phorton1/Arduino-fridgeController/docs/images/elec_board1_schematic_big.jpg

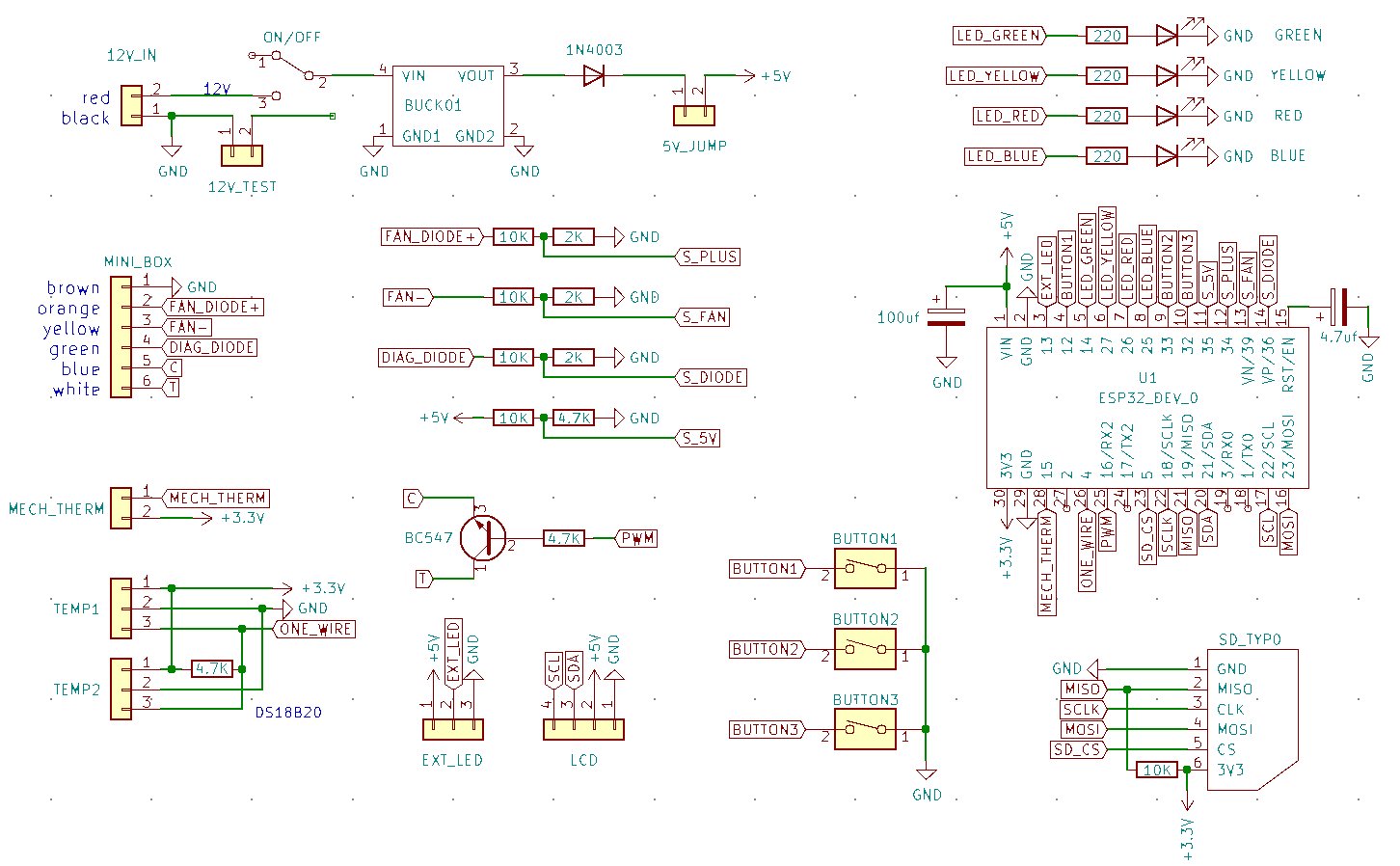
docs/images/elec_board1_schematic_big.jpg
