phorton1/Arduino-fridgeController/docs/images/miniBoxCover_lightburn.jpg

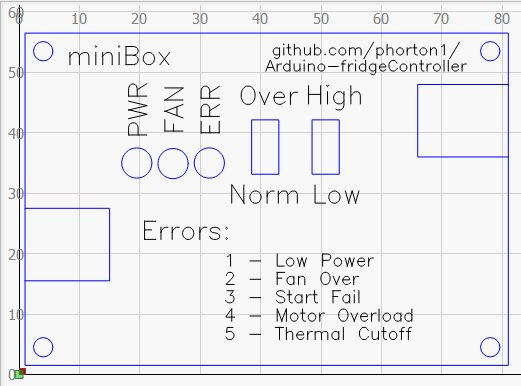
docs/images/miniBoxCover_lightburn.jpg
