phorton1/Arduino-fridgeController/docs/fusion/ext_lens.stl

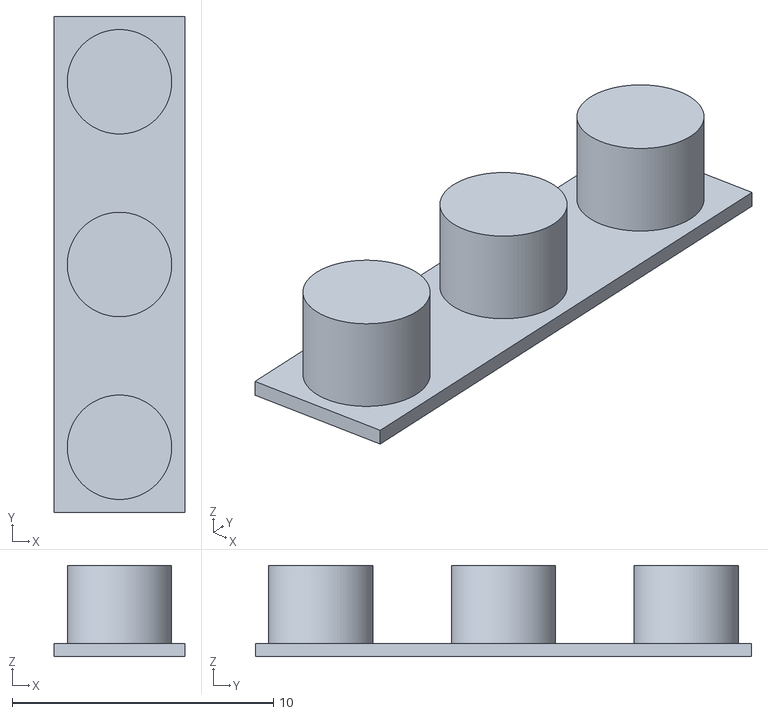
[picture p24: CAD file, 2024-10-18]
docs/fusion/ext_lens.stl
5.00 x 19.0 x 3.50
