phorton1/Arduino-fridgeController/docs/prusa/ext_led_parts.3mf

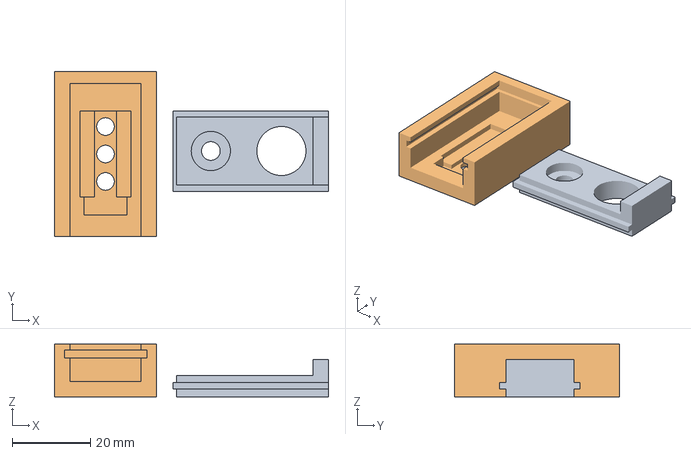
[picture p25: CAD file, 2024-10-18]
docs/prusa/ext_led_parts.3mf
69.9 x 42.0 x 13.5 mm
ext_base.stl
ext_top.stl
