phorton1/Arduino-fridgeController/docs/fusion/ext_top.stl

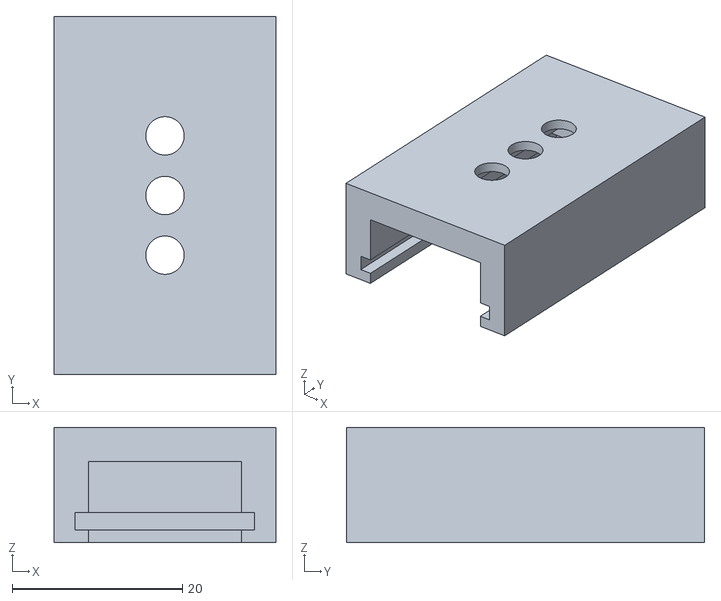
[picture p26: CAD file, 2024-10-18]
docs/fusion/ext_top.stl
26.0 x 42.0 x 13.5
