phorton1/Arduino-fridgeController/docs/prusa/stress_relief_bracket.3mf

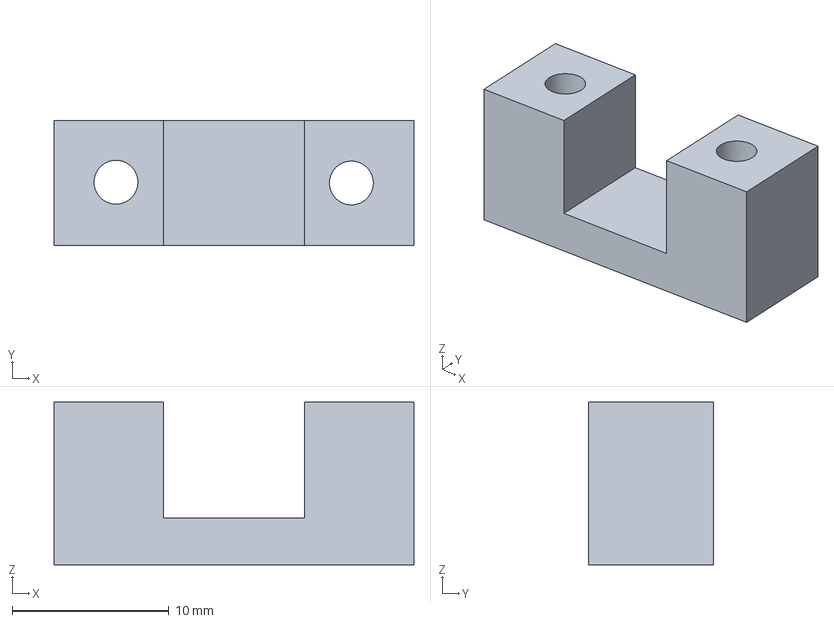
[picture p27: CAD file, 2024-10-18]
docs/prusa/stress_relief_bracket.3mf
23.0 x 8.00 x 10.4 mm
