phorton1/Arduino-fridgeController/docs/fusion/ext_base.stl

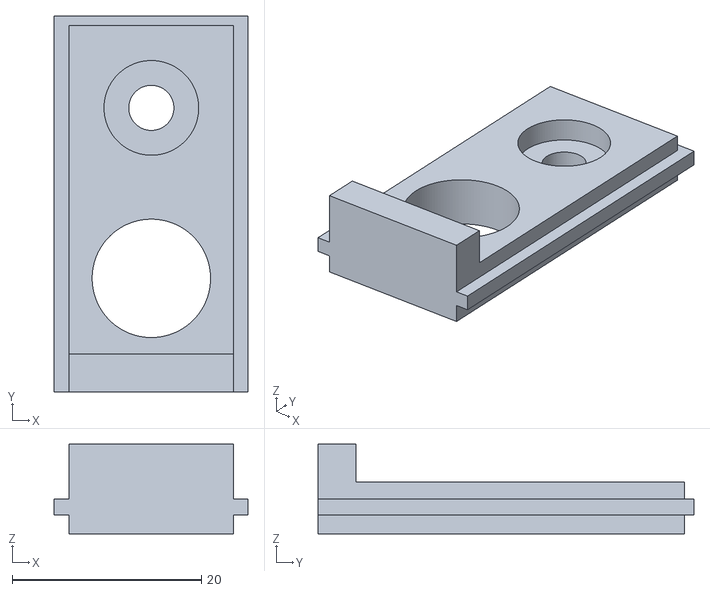
[picture p28: CAD file, 2024-10-18]
docs/fusion/ext_base.stl
20.5 x 39.7 x 9.50
