phorton1/Arduino-fridgeController/docs/prusa/cover_clips.3mf

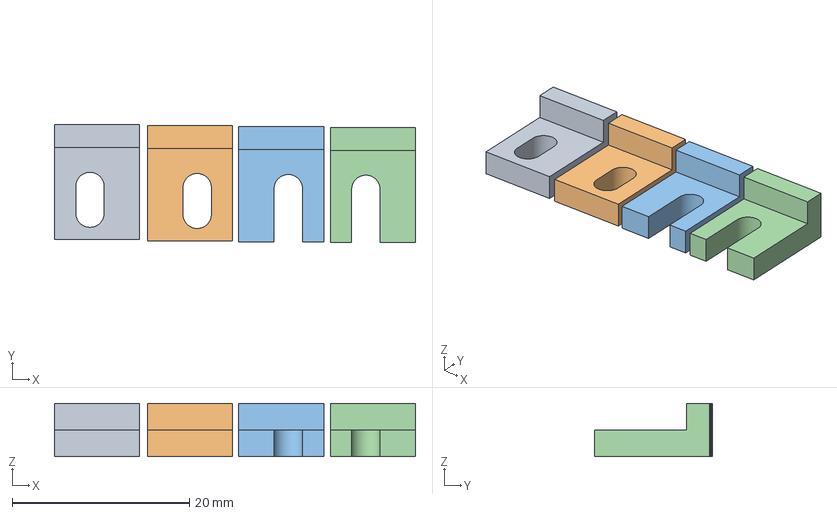
[picture p29: CAD file, 2024-10-11]
docs/prusa/cover_clips.3mf
40.7 x 13.3 x 6.00 mm
cover_clip_bl.stl
cover_clip_br.stl
cover_clip_tr.stl
cover_ clip_tl.stl
