phorton1/Arduino-fridgeController/docs/fusion/cover_clip_bl.stl

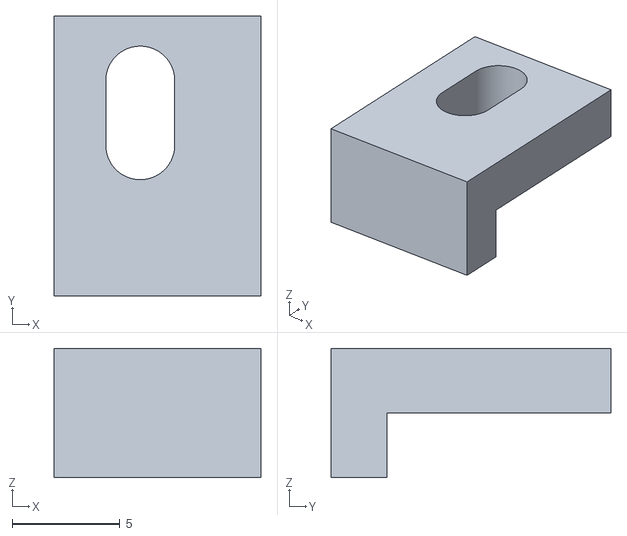
[picture p30: CAD file, 2024-10-11]
docs/fusion/cover_clip_bl.stl
9.60 x 13.0 x 6.00
