phorton1/Arduino-fridgeController/docs/prusa/Lenses.3mf

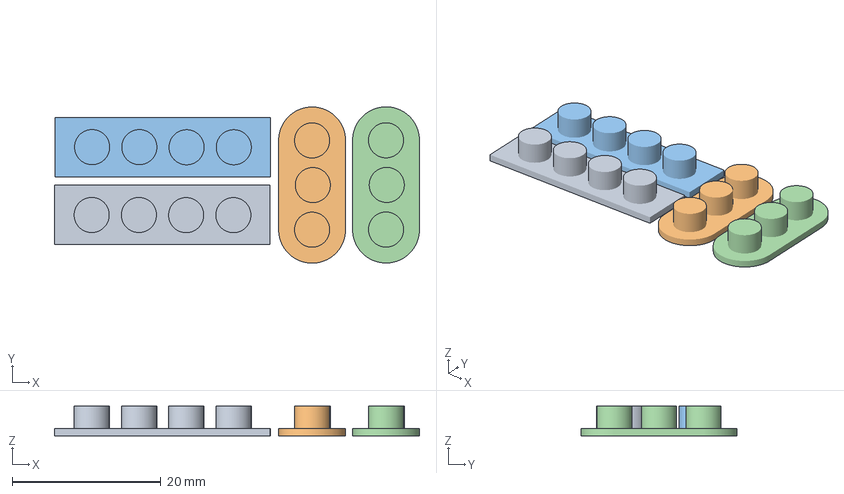
[picture p31: CAD file, 2024-10-10]
docs/prusa/Lenses.3mf
49.1 x 21.0 x 4.00 mm
Controller_led_lens.stl x 2
miniBox_lens.stl x 2
