phorton1/Arduino-fridgeController/docs/fusion/cover_ clip_tl.stl

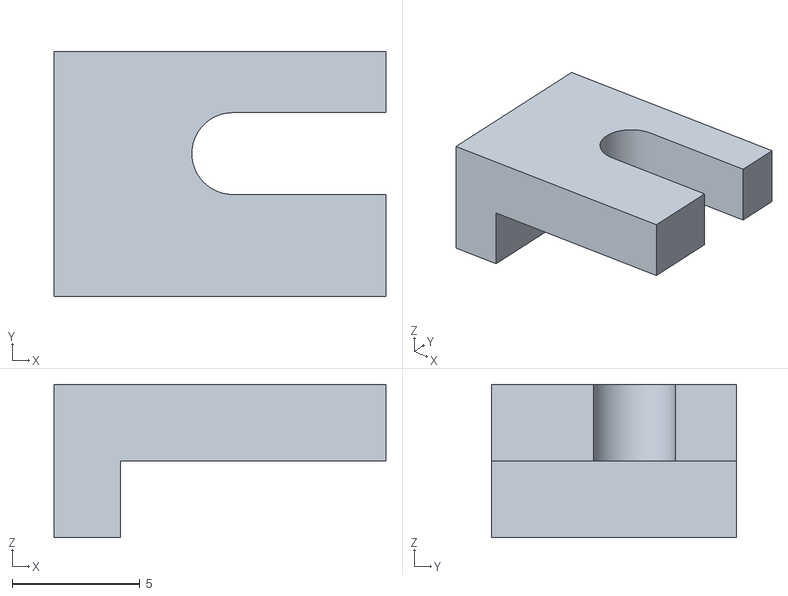
[picture p32: CAD file, 2024-10-11]
docs/fusion/cover_ clip_tl.stl
13.0 x 9.60 x 6.00
