phorton1/Arduino-fridgeController/docs/prusa/miniBox_lens_shield.3mf

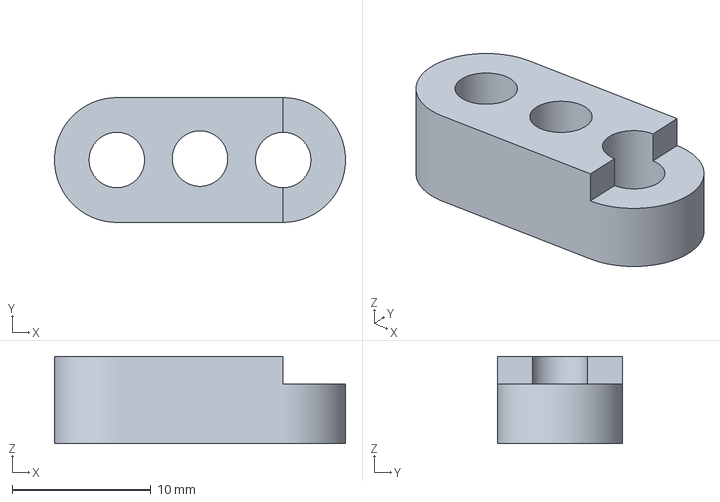
[picture p33: CAD file, 2024-10-08]
docs/prusa/miniBox_lens_shield.3mf
21.0 x 9.00 x 6.30 mm
