phorton1/Arduino-fridgeController/docs/prusa/ControllerParts.3mf

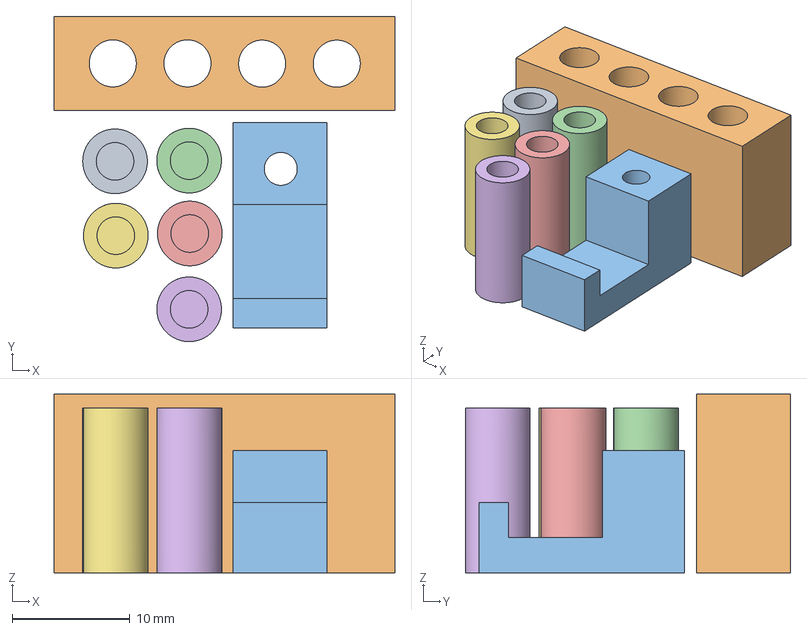
[picture p34: CAD file, 2024-10-08]
docs/prusa/ControllerParts.3mf
29.0 x 27.7 x 15.2 mm
button_cap1_smaller.stl x 2
Controller_led_shield.stl
stress_relief_bracket.stl
button_cap2.stl x 3
