phorton1/Arduino-fridgeController/docs/fusion/Controller_base.3mf

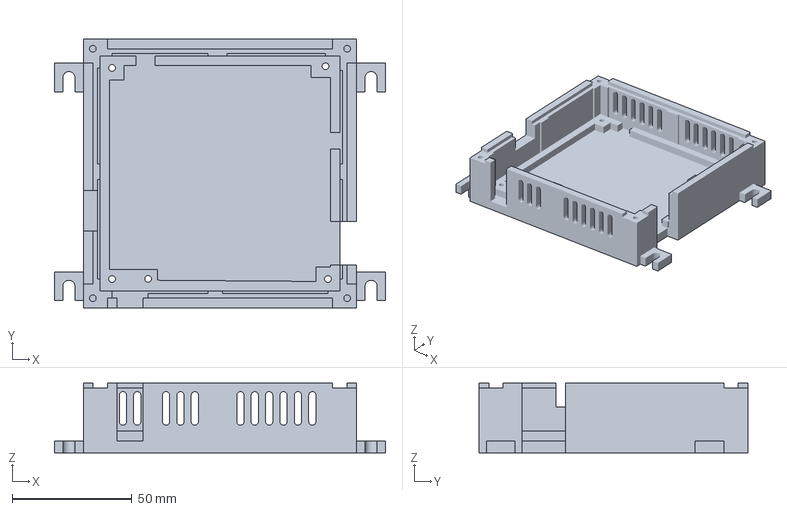
[picture p35: CAD file, 2024-10-11]
docs/fusion/Controller_base.3mf
138.0 x 112.0 x 29.0 mm
