phorton1/Arduino-fridgeController/docs/prusa/spade_connector_bottom.3mf

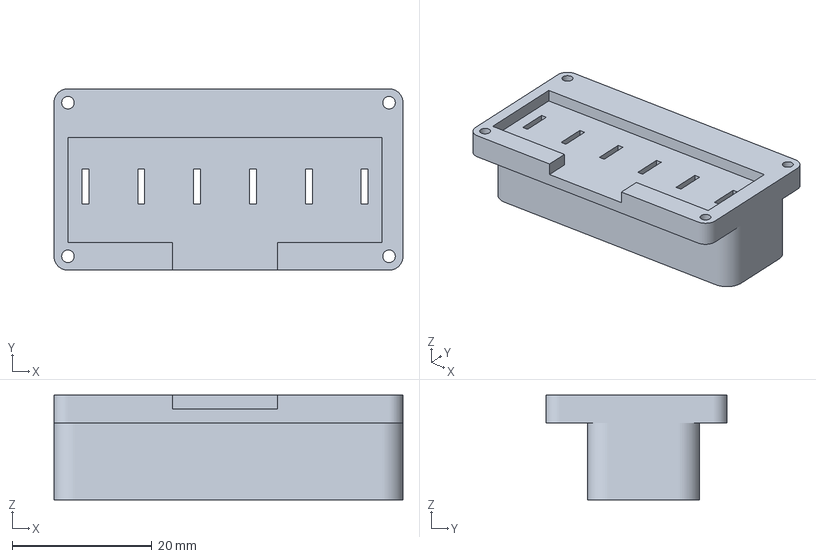
[picture p36: CAD file, 2024-10-06]
docs/prusa/spade_connector_bottom.3mf
50.0 x 26.0 x 15.0 mm
