phorton1/Arduino-fridgeController/docs/prusa/spade_connector_top.3mf

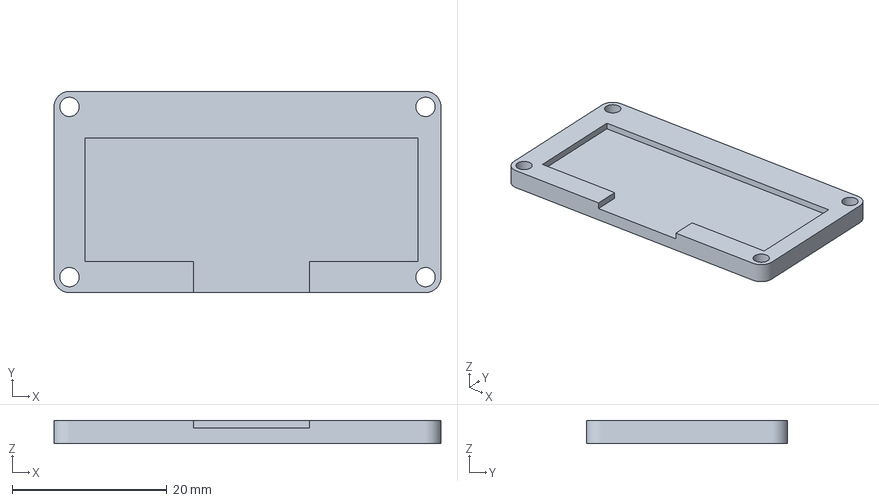
[picture p37: CAD file, 2024-10-06]
docs/prusa/spade_connector_top.3mf
50.0 x 26.0 x 3.00 mm
