phorton1/Arduino-fridgeController/docs/fusion/Controller_led_lens.stl

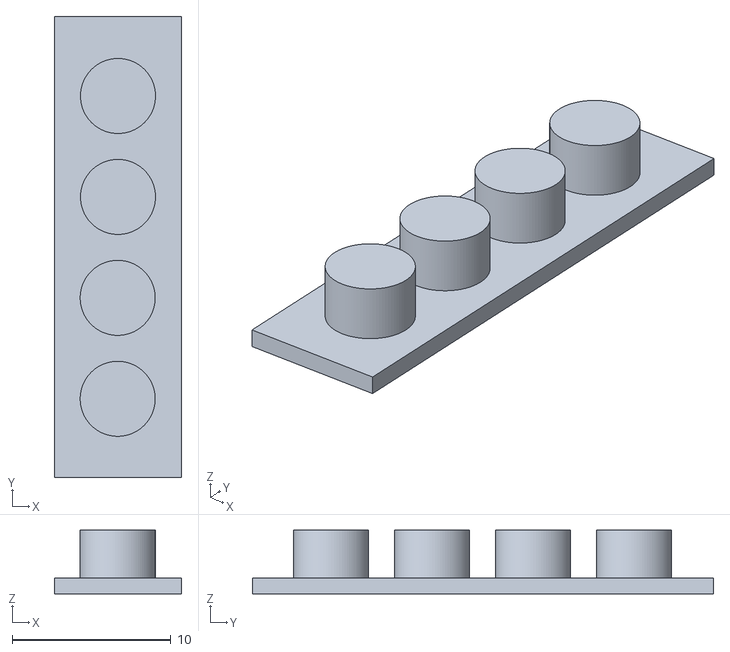
[picture p38: CAD file, 2024-10-10]
docs/fusion/Controller_led_lens.stl
8.00 x 29.0 x 4.00
