phorton1/Arduino-fridgeController/docs/prusa/lcd_mount.3mf

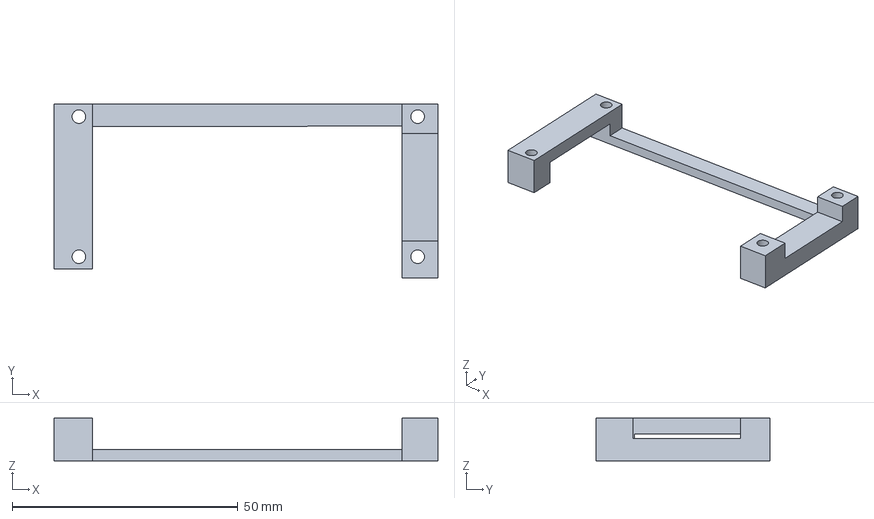
[picture p39: CAD file, 2024-10-06]
docs/prusa/lcd_mount.3mf
85.0 x 38.5 x 9.50 mm
