phorton1/Arduino-fridgeController/docs/fusion/miniBox_lens.stl

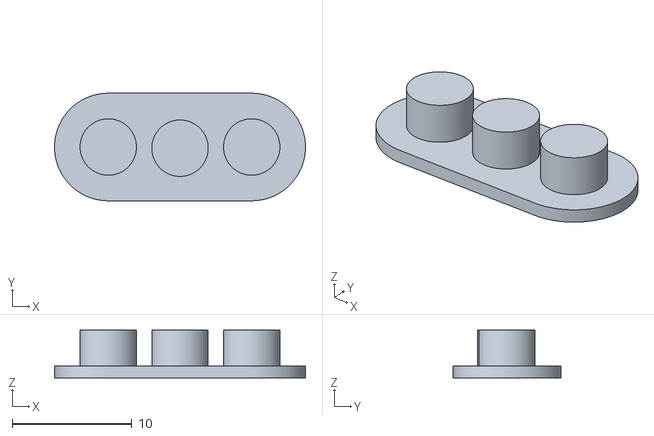
[picture p40: CAD file, 2024-10-10]
docs/fusion/miniBox_lens.stl
21.0 x 9.00 x 4.00
