phorton1/Arduino-fridgeController/docs/fusion/button_cap2.stl

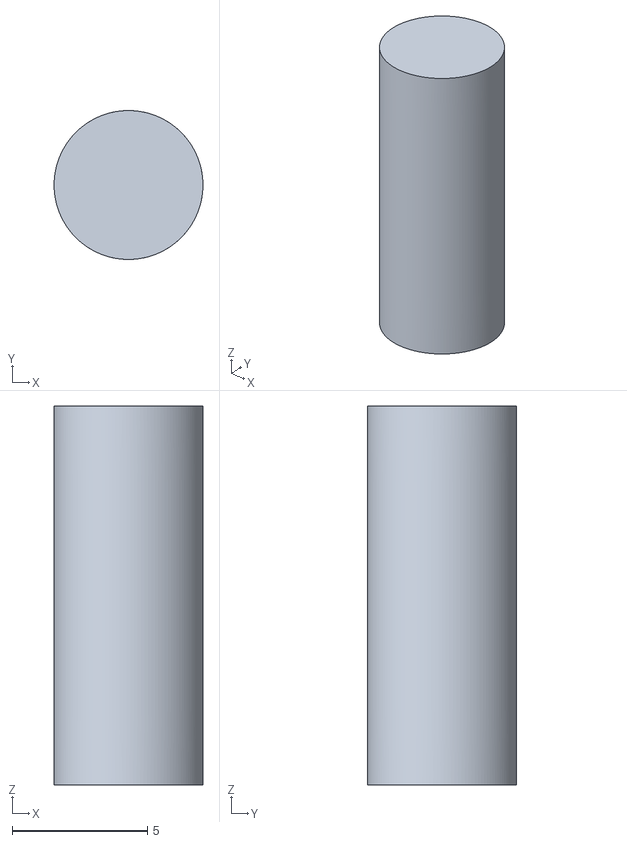
[picture p41: CAD file, 2024-10-08]
docs/fusion/button_cap2.stl
5.50 x 5.50 x 14.0
