phorton1/Arduino-fridgeController/docs/fusion/button_cap1_smaller.stl

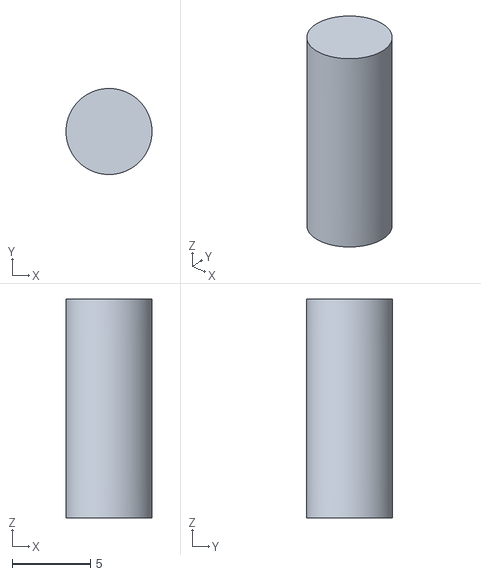
[picture p42: CAD file, 2024-10-08]
docs/fusion/button_cap1_smaller.stl
5.50 x 5.50 x 14.0
