phorton1/Arduino-fridgeController/docs/fusion/Controller_top.dxf

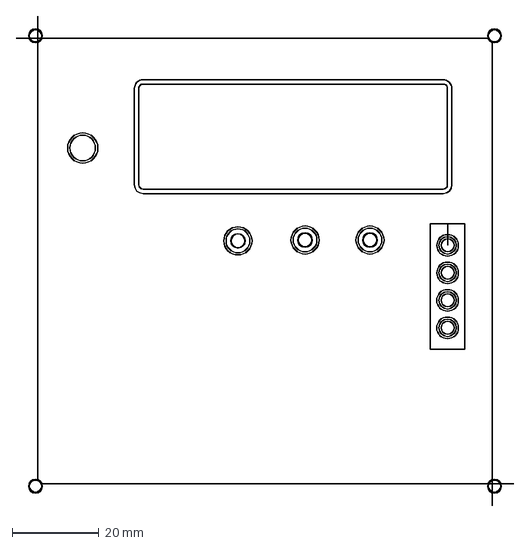
[picture p43: CAD file, 2024-10-08]
docs/fusion/Controller_top.dxf
115.0 x 113.0 mm
