phorton1/Arduino-fridgeController/docs/fusion/Controller_led_shield.stl

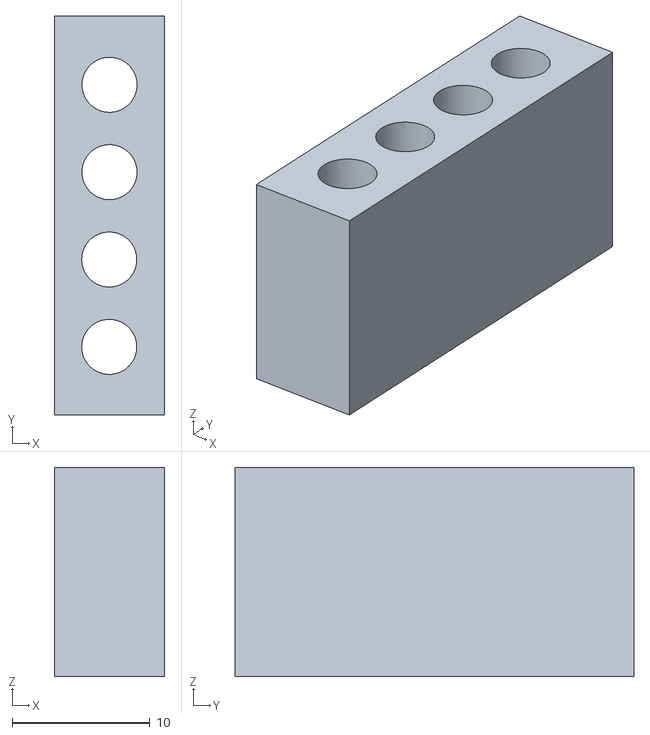
[picture p44: CAD file, 2024-10-08]
docs/fusion/Controller_led_shield.stl
8.00 x 29.0 x 15.2
