phorton1/Arduino-fridgeController/docs/fusion/miniBox_inside_top.dxf

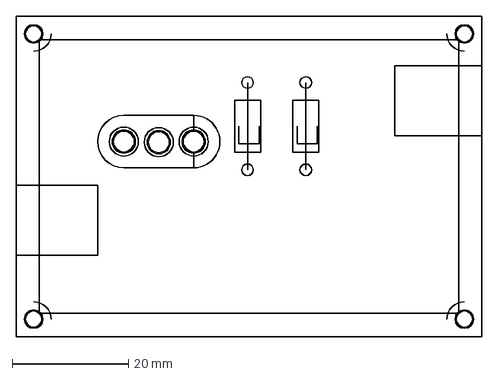
[picture p45: CAD file, 2024-10-08]
docs/fusion/miniBox_inside_top.dxf
80.0 x 55.0 mm
