phorton1/Arduino-fridgeController/docs/fusion/miniBox_base_bottom.3mf

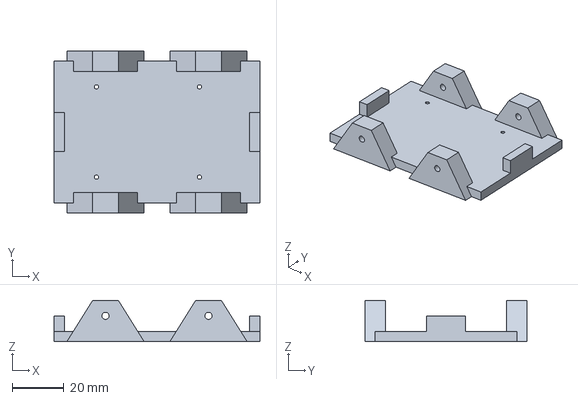
[picture p46: CAD file, 2024-10-07]
docs/fusion/miniBox_base_bottom.3mf
80.0 x 63.0 x 16.0 mm
