phorton1/Arduino-fridgeController/docs/fusion/miniBox_base_top.3mf

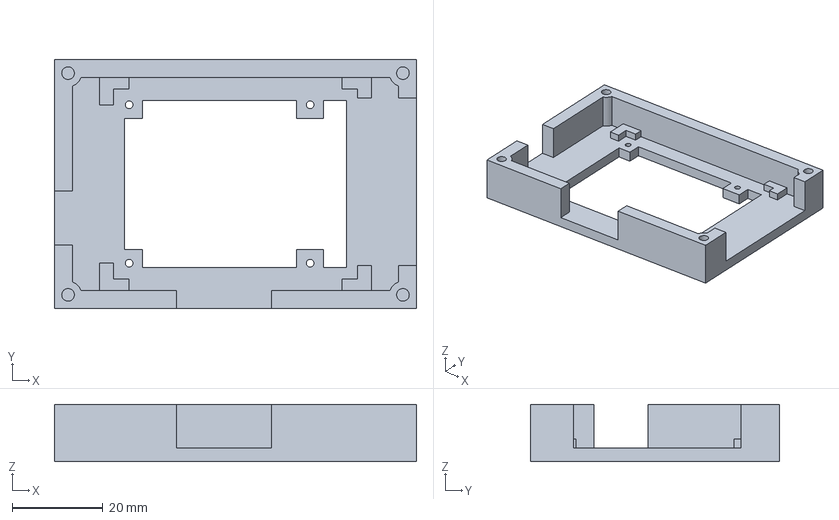
[picture p47: CAD file, 2024-10-06]
docs/fusion/miniBox_base_top.3mf
80.0 x 55.0 x 12.6 mm
