phorton1/Arduino-fridgeController/(list of files, cad)

Other CAD files:
docs/prusa/ext_lens.3mf
docs/fusion/stress_relief_bracket.stl
docs/fusion/cover_clip_br.stl
docs/fusion/cover_clip_tr.stl
docs/fusion/miniBox_lens_shield.stl
docs/fusion/lcd_mount.stl
docs/fusion/spade_connector_bottom.stl
docs/fusion/spade_connector_top.stl
docs/fusion/Controller_base.stl
docs/fusion/miniBox.f3d
docs/fusion/miniBox_base_bottom.stl
docs/fusion/miniBox_base_top.stl
