phorton1/Arduino-fridgeController/docs/images/build_Controller_animation1.jpg

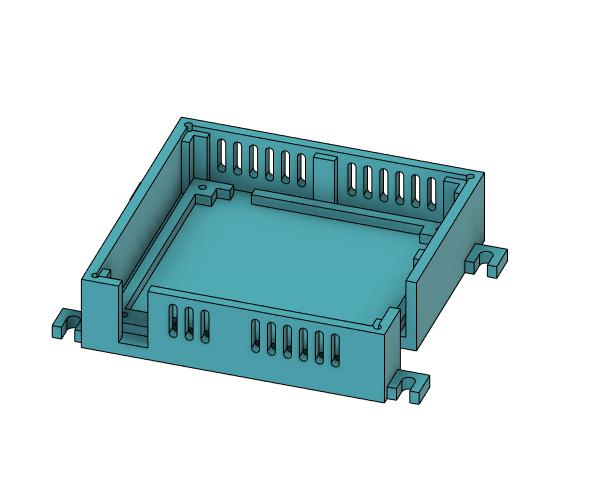
docs/images/build_Controller_animation1.jpg
