phorton1/Arduino-fridgeController/docs/images/build_miniBox_animation1.jpg

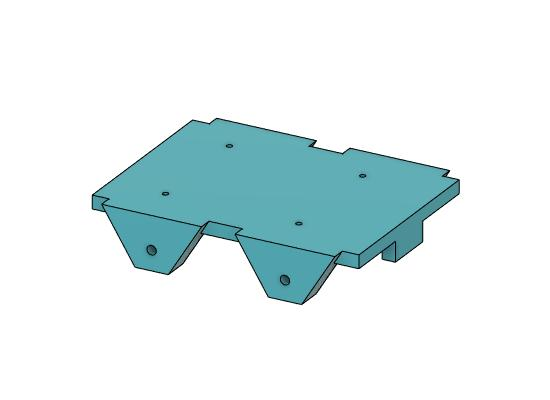
docs/images/build_miniBox_animation1.jpg
