phorton1/Arduino-fridgeController/docs/images/build_miniBox_animation2.jpg

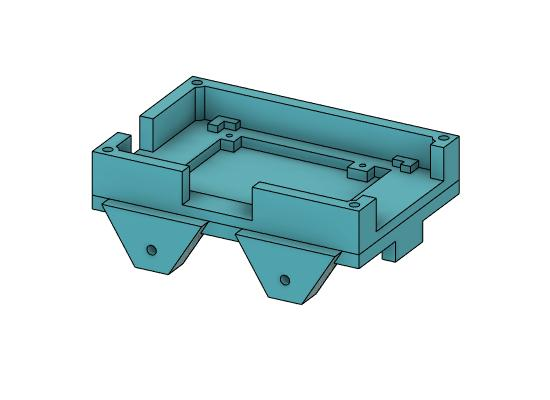
docs/images/build_miniBox_animation2.jpg
