phorton1/Arduino-fridgeController/docs/images/build_miniBox_animation3.jpg

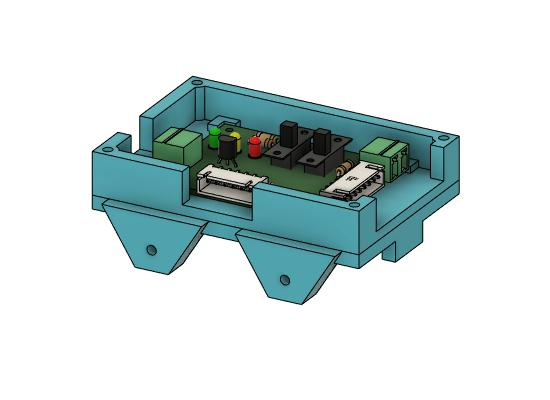
docs/images/build_miniBox_animation3.jpg
