phorton1/Arduino-fridgeController/docs/images/build_miniBox_animation5.jpg

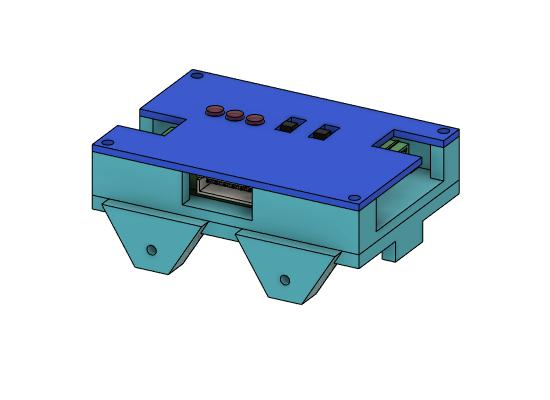
docs/images/build_miniBox_animation5.jpg
