phorton1/Arduino-fridgeController/docs/kicad/board1/board1.kicad_pcb

## KiCad design docs/kicad/board1/board1.kicad_pcb (2024-10-06)

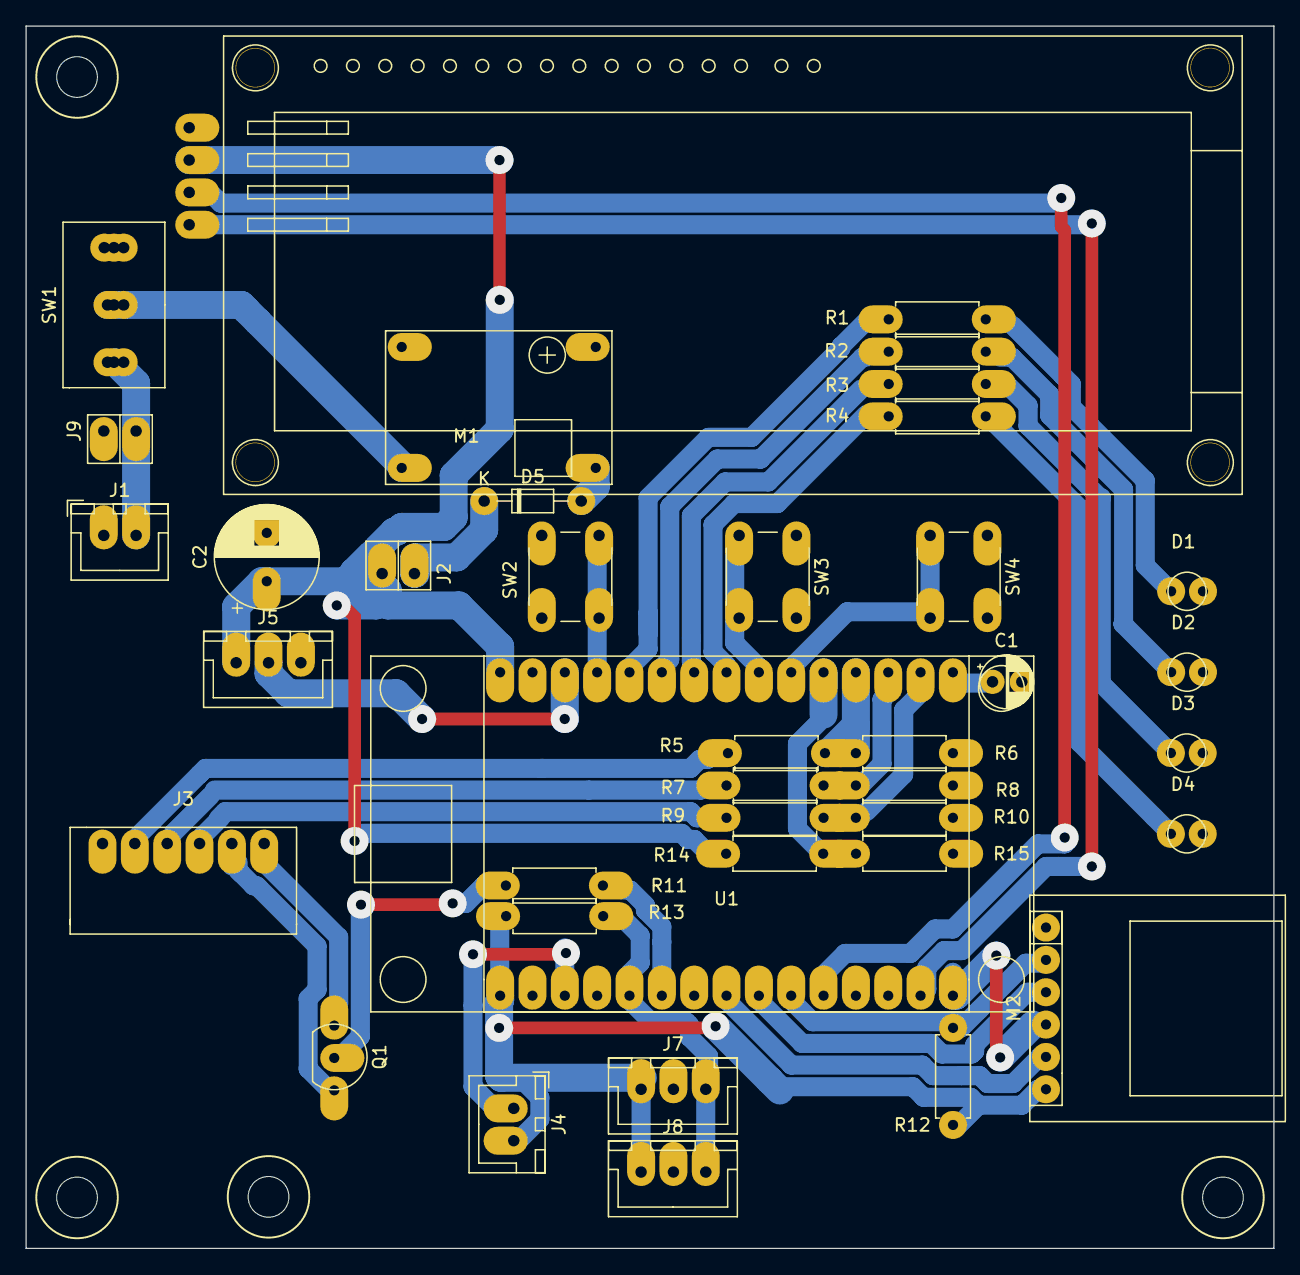
[picture p57: board board1.kicad_pcb from above]

Board: 2 copper layers, 98.0 x 96.0 mm, 39 parts (0 on the bottom side), 39 nets.

Parts:
C1: 4.7uf; CP_my10uf
C2: 100uf; CP_my100uf
D1: GREEN; led_small_green
D2: YELLOW; led_small_yellow
D3: RED; led_small_red
D4: BLUE; led_small_blue
D5: 1N4003; myZenerDiode
J1: 12V_IN; myJSTx02
J2: 5V_JUMP; pinHeader1x2
J3: MINI_BOX; myJST6_right
J4: MECH_THERM; myJSTx02
J5: EXT_LED; JST3
J6: LCD; myLCD_2x16
J7: TEMP1; JST3
J8: TEMP2; JST3
J9: 12V_TEST; pinHeader1x2
M1: BUCK01; buck-mini360
M2: SD_TYP0; SDCardReader
Q1: BC547; transistor
R1, R2, R3, R4: 220; resistor
R5, R7, R9, R12, R14: 10K; resistor
R6, R8, R10: 2K; resistor
R11, R13, R15: 4.7K; resistor
SW1: ON/OFF; SW_DPDT_BLUE_LEVER
SW2: BUTTON1; button_6mm_H12
SW3: BUTTON2; button_6mm_H12
SW4: BUTTON3; button_6mm_H12
U1: ESP32_DEV_0; esp32_dev_0

Connections:
+3V3: J4.2, J7.1, J8.1, M2.6, R12.1, R13.1, U1.30
+5V: C2.1, J2.2, J5.1, J6.2, R14.2, U1.1
BUTTON1: SW2.2, U1.4
BUTTON2: SW3.2, U1.9
BUTTON3: SW4.2, U1.10
C: J3.5, Q1.3
DIAG_DIODE: J3.4, R9.2
EXT_LED: J5.2, U1.3
FAN-: J3.3, R7.2
FAN_DIODE+: J3.2, R5.2
GND: C1.2, C2.2, D1.1, D2.1, D3.1, D4.1, J1.1, J3.1, J5.3, J6.1, J7.2, J8.2, J9.1, M1.1, M1.2, M2.1, R6.1, R8.1, R10.1, R15.1, SW2.1, SW3.1, SW4.1, U1.2, U1.29
LED_BLUE: R4.2, U1.8
LED_GREEN: R1.2, U1.5
LED_RED: R3.2, U1.7
LED_YELLOW: R2.2, U1.6
MECH_THERM: J4.1, U1.28
MISO: M2.2, R12.2, U1.21
MOSI: M2.4, U1.16
unnamed: C1.1, U1.15
unnamed: D1.2, R1.1
unnamed: D2.2, R2.1
unnamed: D3.2, R3.1
unnamed: D4.2, R4.1
unnamed: D5.1, J2.1
unnamed: D5.2, M1.3
unnamed: J1.2, SW1.3
unnamed: M1.4, SW1.2
unnamed: Q1.2, R11.2
ONE_WIRE: J7.3, J8.3, R13.2, U1.26
PWM: R11.1, U1.25
SCL: J6.4, U1.17
SCLK: M2.3, U1.22
SDA: J6.3, U1.20
SD_CS: M2.5, U1.23
S_5V: R14.1, R15.2, U1.11
S_DIODE: R9.1, R10.2, U1.14
S_FAN: R7.1, R8.2, U1.13
S_PLUS: R5.1, R6.2, U1.12
T: J3.6, Q1.1
