phorton1/Arduino-fridgeController/docs/kicad/miniBox/miniBox.kicad_pcb

## KiCad design docs/kicad/miniBox/miniBox.kicad_pcb (2024-10-06)

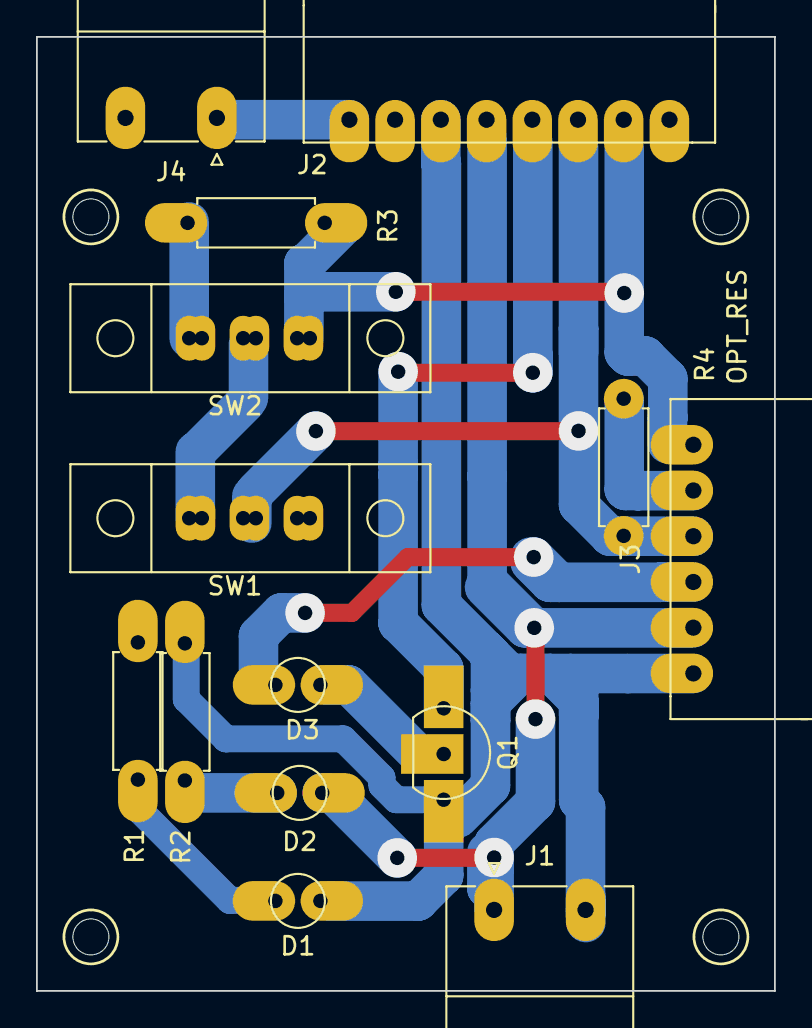
[picture p58: board miniBox.kicad_pcb from above]

Board: 2 copper layers, 41.0 x 53.0 mm, 14 parts (0 on the bottom side), 14 nets.

Parts:
D1: GREEN; led_small_green
D2: YELLOW; led_small_yellow
D3: RED; led_small_red
J1: FAN; PhoenixContact_MC_1,5_2-G-5.08_1x02_P5.08mm_Horizontal
J2: CONTROLLER; myJST8_right
J3: INV_CONN; myJST6_right
J4: INV_PWR; PhoenixContact_MC_1,5_2-G-5.08_1x02_P5.08mm_Horizontal
Q1: BC557 PNP; transistor
R1: 1K; resistor
R2, R3: 1.5K; resistor
R4: 10K?; resistor
SW1: OVERRIDE; SlideSPDT_small
SW2: LOW/HIGH; SlideSPDT_small

Connections:
+12V: J2.8, J4.1
C: J2.3, J3.4, R4.2, SW1.2
DIAG_DIODE: J2.4, Q1.1
DIODE-: D3.1, J3.3
FAN-: D2.1, J1.1, J2.5, J3.2
FAN_DIODE+: D1.2, J1.2, J2.6, J3.1, Q1.3, R2.1
GND: J2.1, J2.7, J4.2, R1.1
unnamed: D1.1, R1.2
unnamed: D2.2, R2.2
unnamed: D3.2, Q1.2
unnamed: R3.2, SW2.3
unnamed: SW1.3, SW2.2
P: J3.5, R4.1
T: J2.2, J3.6, R3.1, SW2.1
