phorton1/Arduino-fridgeController/(commit log)

2024-09-08 add unused S_5V pin to kicad/board1 ESP32
    [board1.sch]
2024-09-08 initial factoring; implemented DS18B20 OneWire temperature sensor based on Arduino DallasTemperature library
2024-09-08 initial factor Arduino-frigeController to myIOT
2024-09-13 produced fridgeController pcb's "board1" and "miniBox"
    [board1.kicad_pcb, board1.sch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]
2024-09-15 sanity checkin - back from foray into Arduino2, ESP32S3, ESP32 Cores 1_0_6 and 3_0_4, munged /AppData/Local/Arduino15 directory Most of these changes revolve around anticipating issues if and when I 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
    [fridge.cpp, fridge.h, fridgeController.ino, uiScreen.cpp]
2024-09-15 minor changes before more testing ArduinoIDE2.3.3 and Esp32Core3.0.4 on LENOVO-T490-2
    [board1.kicad_pcb, board1.sch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]
2024-09-20 added actual SD card dataLogging with - rudimentary seconds "period" based UI - enhancedLegendRenderer allows toggling of series display - reverse order of canvases so 0 is on top - bringing series t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
    [fridge.cpp]
2024-09-21 first simple Widget prototype testing; WIP on fridgeController, onCustomLink() idea, caching, and charting
2024-09-21 submodule(data) auto_commit(83767cf1) Added a Widget tab to the main myIOT webpage; added jqplot CSS and JS files; wrote iotPlot.js prototype of charting within a "widget" - see fridgeController chec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
2024-09-25 submodule(data) auto_commit(331f60b7) refined myIOT plotter with LEGENDS and using device specific PLOT_TYPES if available; theClock3 implementation of PLOT_CYCLES and PLOT_WAVES
2024-09-26 prep for bilgeAlarm bar chart widget - reworked myIOTDataLog to send records from back of file until dt stamp is met, which required myIOTWebServer to use HTTP 1.0 to send binary data with unknown co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
    [fridge.cpp]
2024-09-27 reworked bilgeAlarm to use simplified myIOTDataLog and rely on SD card. changed WIP fridgeController as a result
    [fridge.cpp]
2024-09-29 added prototype bilgeAlarm jqPlot Widget using added "alt_data_format" and custom chart_header and chart_data code in onCustomLink(). modified myIOT/data index.html, iotChart.js, and iotCommon.js
2024-09-29 submodule(data) auto_commit(416ed000) added prototype bilgeAlarm jqPlot Widget using added "alt_data_format" and custom chart_header and chart_data code in onCustomLink(). modified myIOT/data index.h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
2024-10-02 implement initial uiScreen (only missing static POWER screen)
    [fridge.cpp, fridge.h, fridgeController.ino, uiScreen.cpp, uiScreen.h]
2024-10-03 implement display VOLTAGE - vSense sampling, fridgepublishing, uiScreen, & fakeCompressor & design documentations
2024-10-04 READY TO TRY bench inverter with new cable, changes include - comments - moved COMP_ON BLUE LED logic to setRPM() - More work around with fakeCompressor - turned off /custom/chart_data myIOTHTTP debu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
    [fridge_model.xlsx]
2024-10-06 kicad - miniBox - corrected routing of FAN DIODE from FAN- to FAN/DIODE+ instead of GND
    [miniBox.kicad_pcb, miniBox.sch]
2024-10-06 kicad - board1 - rerouted 5V to LCD; added backflow prevention diode to 5V jumper
    [board1.kicad_pcb, board1.sch]
2024-10-06 first 3D print of miniBox
    [lcd_mount.3mf, lcd_mount.stl, miniBox_base_bottom.3mf, miniBox_base_bottom.stl, miniBox_base_top.3mf, miniBox_base_top.stl, spade_connector_bottom.3mf, spade_connector_bottom.stl]
2024-10-07 documentation WIP - broke out analsys.md, cleanup and spellcheck, add first images
    [miniBox_base_bottom.3mf, miniBox_base_bottom.stl]
2024-10-08 allow CLEAR_ERROR command while FRIDGE_MODE; added CLEAR_ERROR to uiScreen.cpp (doesn't show if no INV_ERROR)
    [fridge.cpp, uiScreen.cpp]
2024-10-08 checkin Fusion 360, Prusa, and Lightburn output after main 3D printing and Laser work;
    [ControllerParts.3mf, Controller_base.3mf, Controller_base.stl, Controller_led_lens.stl, Controller_led_shield.stl, Controller_top.dxf, Lenses.3mf, button_cap1_smaller.stl]
2024-10-10 minor Fusion mods to reprint clear plastic lenses and controllerBox
    [Controller_base.3mf, Controller_base.stl, Controller_led_lens.stl, Lenses.3mf, miniBox.f3d, miniBox_lens.stl]
2024-10-10 add tooltips, external WS2812b pixels; ID_LED_BRIGHTNESS; re-calibrate voltages, general cleanup before installation
2024-10-11 grrr - re-print controllerBox due to lack of cutouts
    [Controller_base.3mf, Controller_base.stl]
2024-10-11 last minute changes - stupid "Cover Clips"
    [Controller_base.3mf, Controller_base.stl, cover_ clip_tl.stl, cover_clip_bl.stl, cover_clip_br.stl, cover_clip_tr.stl, cover_clips.3mf]
2024-10-14 vSense.cpp - USER CIRCULAR BUFFER FOR VOLTAGES; was getting random diode errors
    [vSense.cpp]
2024-10-18 added EXT_LED box and 3rd pixel; changed bootup LED and PIXEL displays; experimented with SSD1306 OLED displays
    [ext_base.stl, ext_led_parts.3mf, ext_lens.3mf, ext_lens.stl, ext_top.stl, stress_relief_bracket.3mf, stress_relief_bracket.stl]
2024-10-19 add Arduino-tempController to github
2024-10-19 minor debug and UI fixes
    [fridge.h, uiScreen.cpp]
2024-10-21 submodule(data) auto_commit(b811e3f8) move generic uiButtons to myIOTButtons; implement initial tempController uiScreen and PCB board(s)
2024-10-24 normalized fridgeController to use myIOT Temperature sensor and Buttons; rename objects in fridgeController and tempController for consistency and name space separation.
2024-10-25 updated temp_chart.html to set and use device_uuid
2024-10-30 chnage Arduino-libraries-myIOT/myTempSensor to myIOTTempSensor to allow for a "my" version that is currently not on github
2025-12-15 submodule(data) auto_commit(b649fc3a) iotChart.js - added scheme for setting device specific series colors
2025-12-18 submodule(data) auto_commit(1adaeb45) reworked iotChart.js incremental update scheme starting with Arduino-boat-drainPump
2025-12-18 submodule(data) auto_commit(b6ac0c88) starting in Arduino-boat-arirco, major rework of iotChart.js and how charts are implemented - use common chart.html instead of specific/extra_data/device_chart.h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
    [fridge.cpp]
2025-12-18 submodule(data) auto_commit(a4e2ed81) change chart.html and iotChart.js to use and remove style "degree_hidden" for devices that chart things with degrees
2026-02-22 myIOTHTTP.cpp: added special case to do token replacement for "data_name" in chart.html AND updated myIOT devices with charts to pass data_name in chart_link
    [fridge.cpp]
2026-02-22 submodule(data) auto_commit(37a6a76c) added framework for chart.html to pass "data_name" to allow multiple charts per device; ALSO store most recent chart period in browser storage
2026-03-05 added "boat" to the myIOTDevice advertised SSDP device URL
2026-03-05 submodule(data) auto_commit(ecc76888) update myIOT data submodule readme.md to remove forward references to actual implmented device repos
